shirriff/GBC-audio-chip/headphone-amp.sch

## KiCad design headphone-amp.sch (2020-05-01)

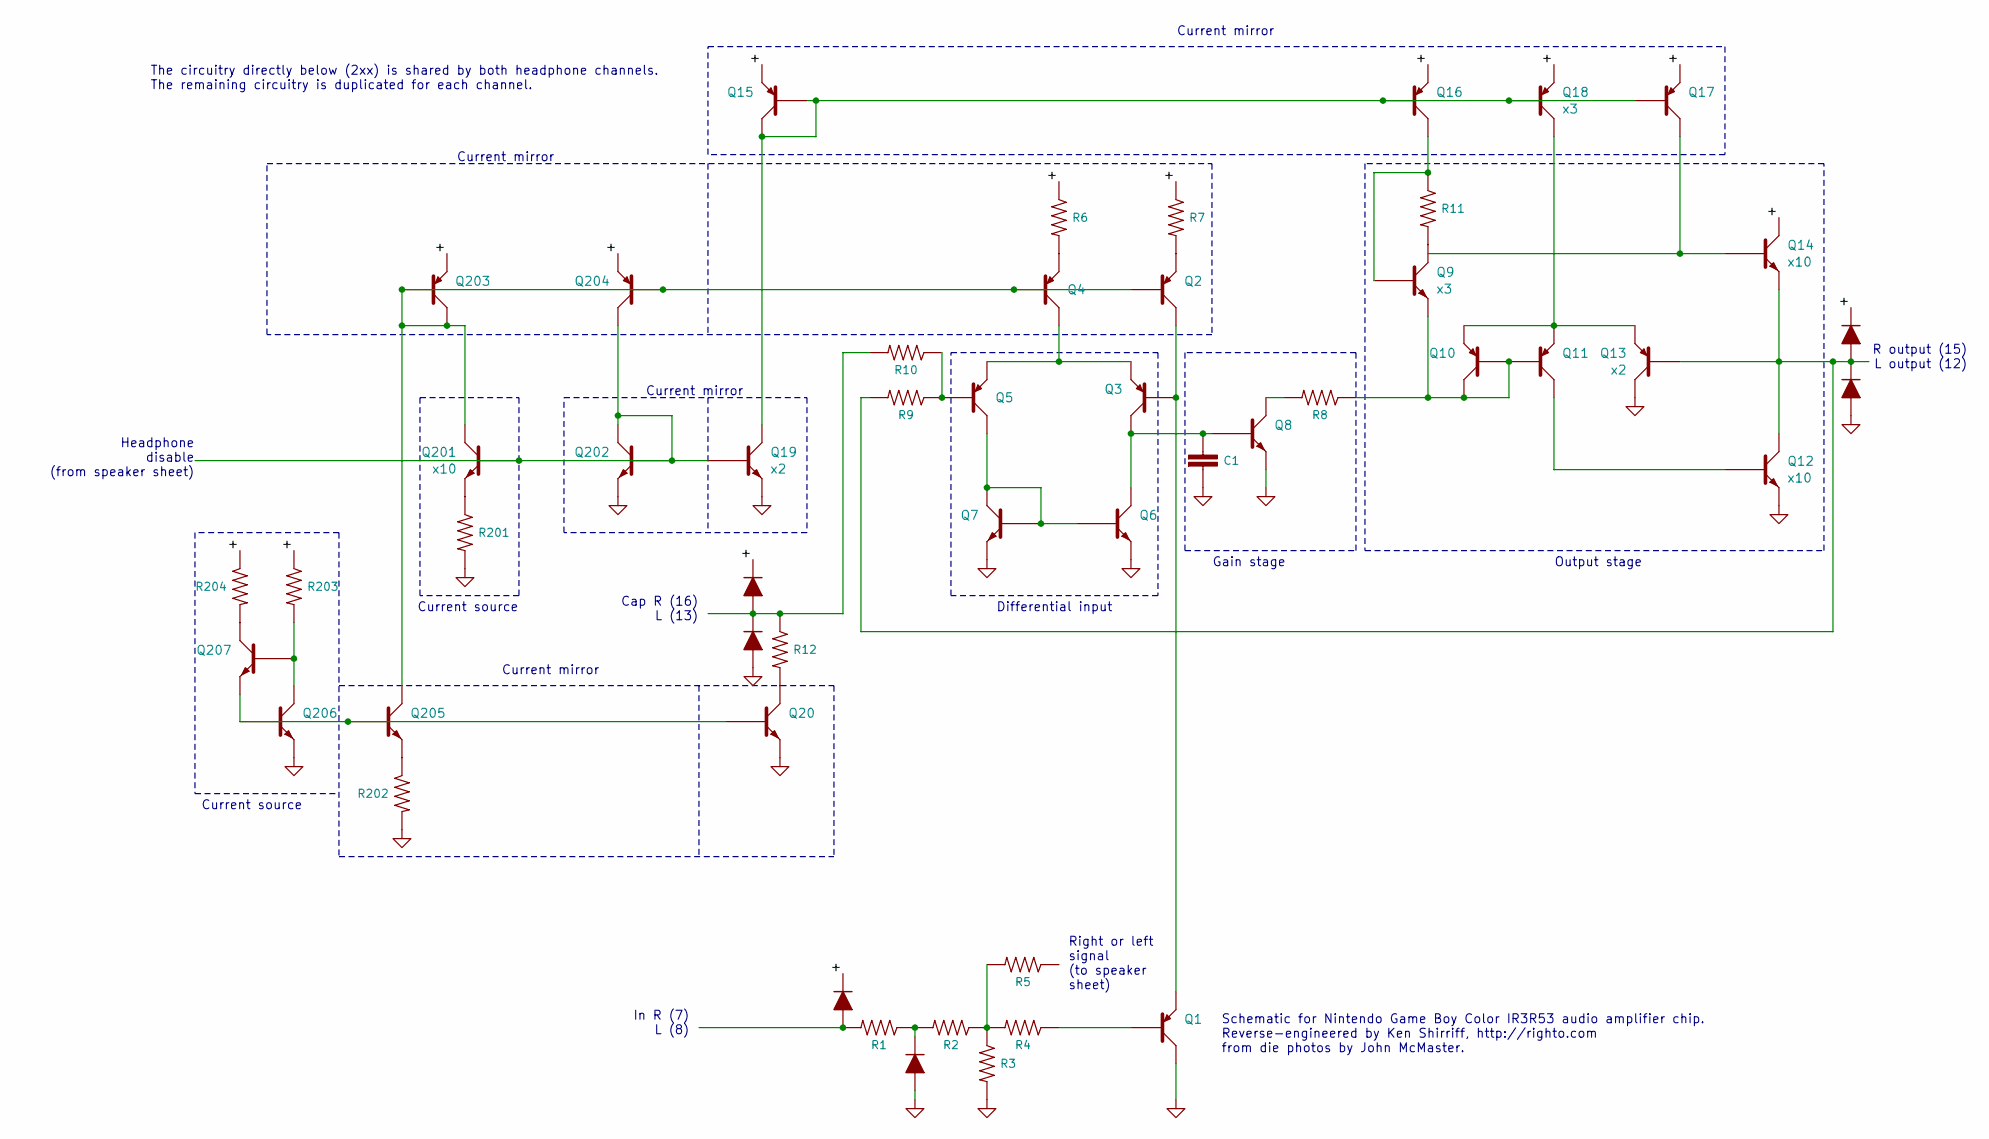
[picture p6: schematic headphone-amp.sch]

Parts:
C1: SPARKFUN-CAPACITORS_0.1UF-0402-16V-10%; SPARKFUN-CAPACITORS_0402
Q1, Q2, Q3, Q4, Q5, Q7, Q15, Q16, Q17, Q202, Q203, Q204, Q205, Q206, Q207: (no value)
Q6, Q8: x6
Q9, Q10, Q11, Q18: x3
Q12, Q14, Q201: x10
Q13, Q19, Q20: x2
R1, R2, R3, R4, R5, R6, R7, R8, R9, R10, R11, R12, R201, R202, R203, R204: SPARKFUN-RESISTORS_0603

Connections:
+: Q14.2 (C), Q15.3 (E), Q16.3 (E), Q17.3 (E), Q18.3 (E), Q203.3 (E), Q204.3 (E), R6.1, R7.1, R203.1, R204.1
GND: C1.2, Q1.2 (C), Q6.3 (E), Q7.3 (E), Q8.3 (E), Q12.3 (E), Q13.2 (C), Q19.3 (E), Q20.3 (E), Q202.3 (E), Q206.3 (E), R3.2, R201.2, R202.2
unnamed: C1.1, Q3.2 (C), Q6.2 (C), Q8.1 (B)
unnamed: Q1.1 (B), R4.1
unnamed: Q1.3 (E), Q2.2 (C), Q3.1 (B)
unnamed: Q2.1 (B), Q4.1 (B), Q201.2 (C), Q203.1 (B), Q203.2 (C), Q204.1 (B), Q205.2 (C)
unnamed: Q2.3 (E), R7.2
unnamed: Q3.3 (E), Q4.2 (C), Q5.3 (E)
unnamed: Q4.3 (E), R6.2
unnamed: Q5.1 (B), R9.1, R10.1
unnamed: Q5.2 (C), Q6.1 (B), Q7.1 (B), Q7.2 (C)
unnamed: Q8.2 (C), R8.2
unnamed: Q9.2 (C), R11.2
unnamed: Q9.3 (E), Q10.1 (B), Q10.2 (C), Q11.1 (B), R8.1
unnamed: Q10.3 (E), Q11.3 (E), Q13.3 (E), Q18.2 (C)
unnamed: Q11.2 (C), Q12.1 (B)
unnamed: Q12.2 (C), Q13.1 (B), Q14.3 (E), R9.2
unnamed: Q14.1 (B), Q17.2 (C)
unnamed: Q15.1 (B), Q15.2 (C), Q16.1 (B), Q17.1 (B), Q18.1 (B), Q19.2 (C)
unnamed: Q9.1 (B), Q16.2 (C), R11.1
unnamed: Q19.1 (B), Q201.1 (B), Q202.1 (B), Q202.2 (C), Q204.2 (C)
unnamed: Q20.1 (B), Q205.1 (B), Q206.1 (B), Q207.3 (E)
unnamed: Q20.2 (C), R12.2
unnamed: Q201.3 (E), R201.1
unnamed: Q205.3 (E), R202.1
unnamed: Q206.2 (C), Q207.1 (B), R203.2
unnamed: Q207.2 (C), R204.2
unnamed: R1.1, R2.2
unnamed: R2.1, R3.1, R4.2, R5.2
unnamed: R10.2, R12.1

Notes on the sheet:
R output (15) L output (12)
Headphone disable (from speaker sheet)
In R (7) L (8)
Right or left signal (to speaker sheet)
Cap R (16) L (13)
Current source
Current mirror
Differential input
Output stage
Gain stage
The circuitry directly below (2xx) is shared by both headphone channels. The remaining circuitry is duplicated for each channel.
Schematic for Nintendo Game Boy Color IR3R53 audio amplifier chip. Reverse-engineered by Ken Shirriff, http://righto.com from die photos by John McMaster.
