shirriff/GBC-audio-chip/speaker-amp.sch

## KiCad design speaker-amp.sch (2020-05-01)

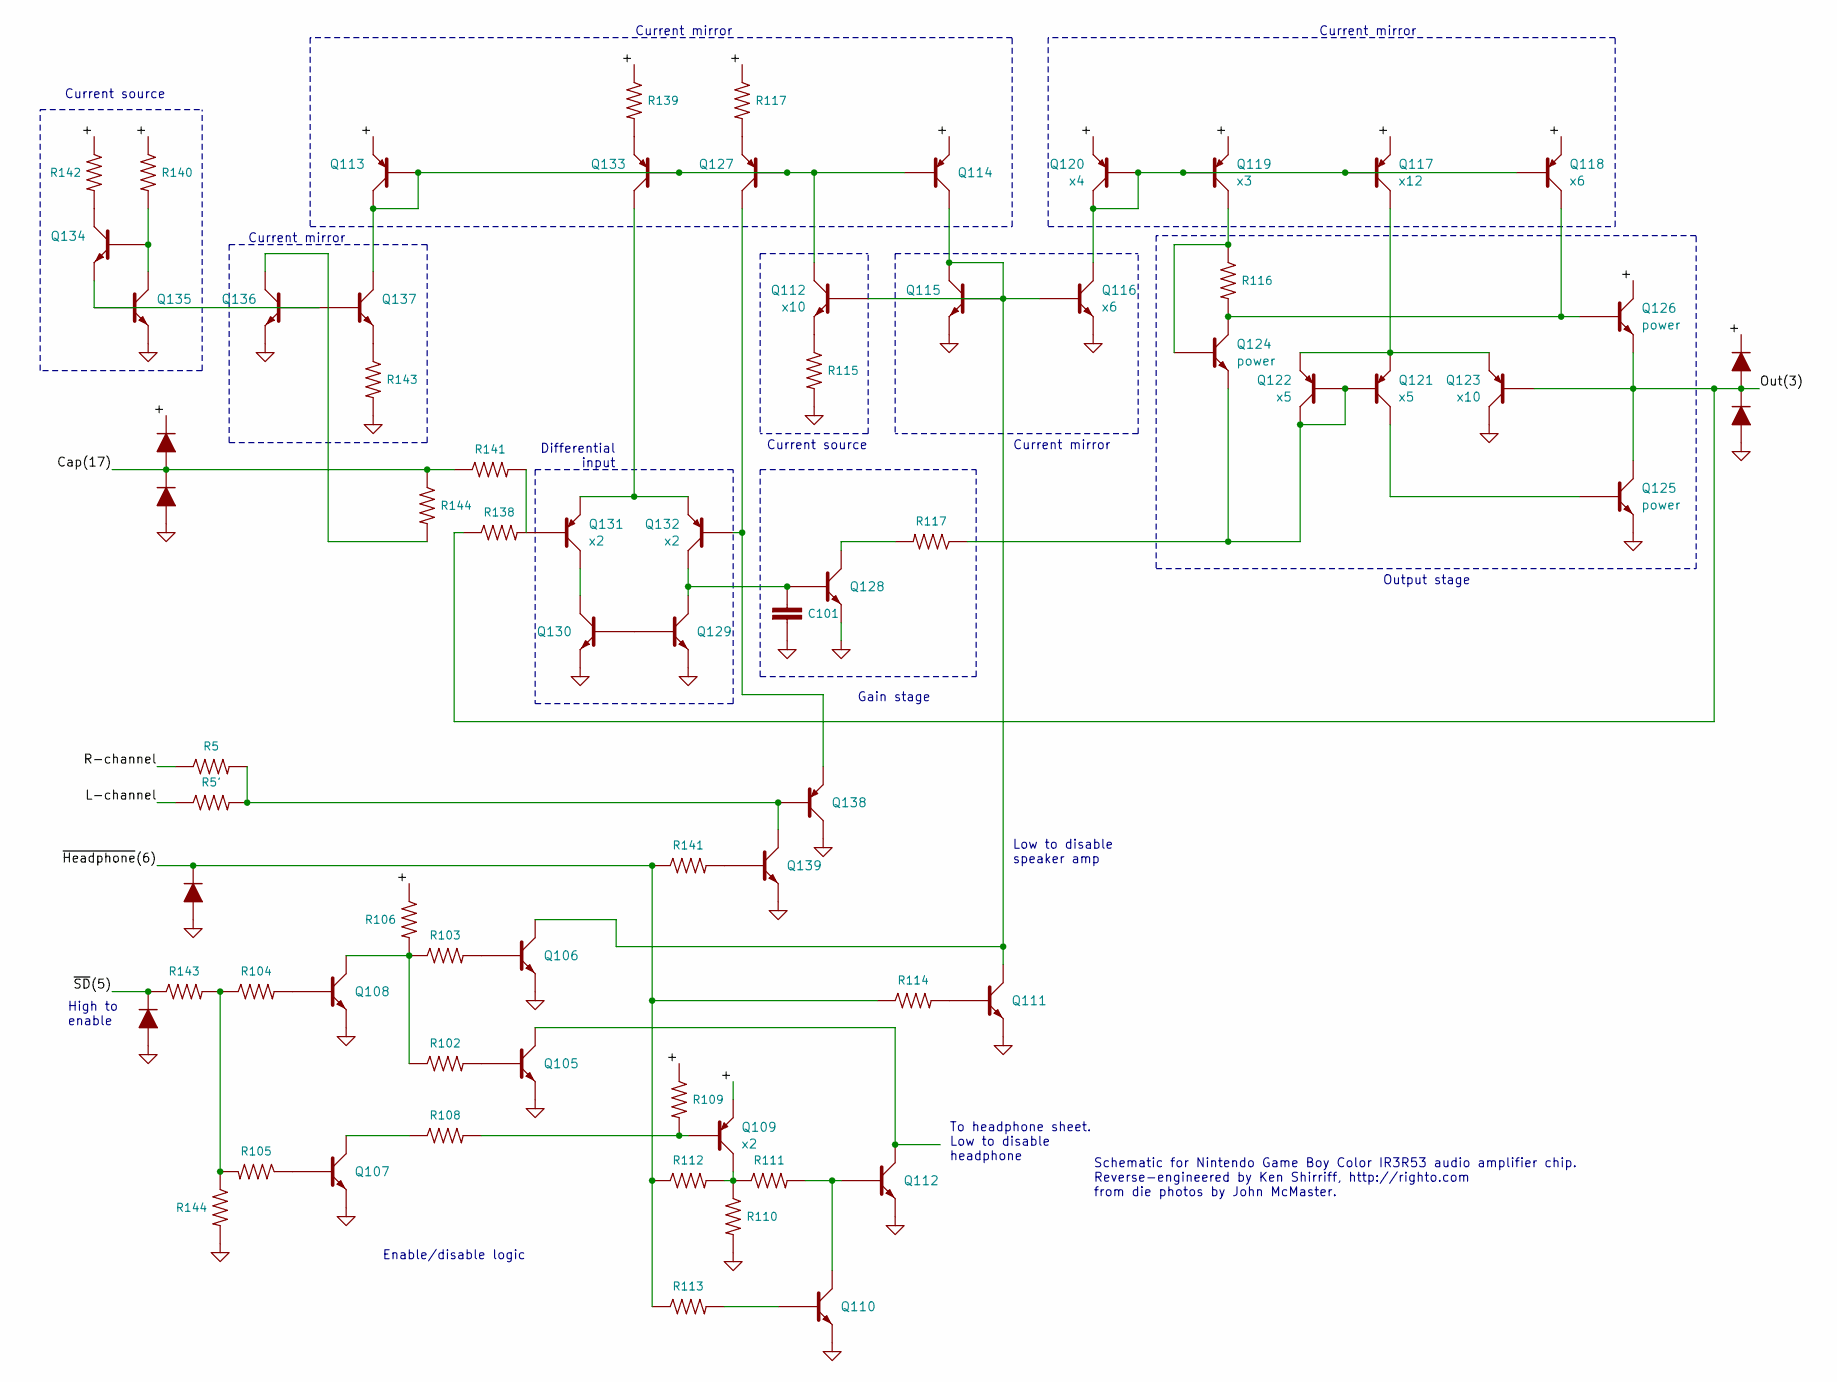
[picture p7: schematic speaker-amp.sch]

Parts:
C101: SPARKFUN-CAPACITORS_0.1UF-0402-16V-10%; SPARKFUN-CAPACITORS_0402
Q105, Q106, Q107, Q108, Q110, Q111, Q113, Q114, Q115, Q127, Q128, Q129, Q130, Q133, Q134, Q135, Q136, Q137, Q138, Q139: (no value)
Q109, Q131, Q132: x2
Q112, Q123: x10
Q116, Q118: x6
Q117: x12
Q119: x3
Q120: x4
Q121, Q122: x5
Q124, Q125, Q126: power
R5, R5', R102, R103, R104, R105, R106, R108, R109, R110, R111, R112, R113, R114, R115, R116, R117, R138, R139, R140, R141, R142, R143, R144: SPARKFUN-RESISTORS_0603

Connections:
+: Q109.3 (E), Q113.3 (E), Q114.3 (E), Q117.3 (E), Q118.3 (E), Q119.3 (E), Q120.3 (E), Q126.2 (C), R106.1, R109.1, R117.1, R139.1, R140.1, R142.1
Cap(17): R141.1, R144.1
GND: C101.2, Q105.3 (E), Q106.3 (E), Q107.3 (E), Q108.3 (E), Q110.3 (E), Q111.3 (E), Q112.3 (E), Q115.3 (E), Q116.3 (E), Q123.2 (C), Q125.3 (E), Q128.3 (E), Q129.3 (E), Q130.3 (E), Q135.3 (E), Q136.3 (E), Q138.2 (C), Q139.3 (E), R110.2, R115.2, R143.2, R144.2
L-channel: R5'.1
unnamed: C101.1, Q128.1 (B), Q129.2 (C), Q132.2 (C)
unnamed: Q105.1 (B), R102.2
unnamed: Q105.2 (C), Q112.2 (C)
unnamed: Q106.1 (B), R103.2
unnamed: Q106.2 (C), Q111.2 (C), Q112.1 (B), Q114.2 (C), Q115.1 (B), Q115.2 (C), Q116.1 (B)
unnamed: Q107.1 (B), R105.1
unnamed: Q107.2 (C), R108.1
unnamed: Q108.1 (B), R104.2
unnamed: Q108.2 (C), R102.1, R103.1, R106.2
unnamed: Q109.1 (B), R108.2, R109.2
unnamed: Q109.2 (C), R110.1, R111.1, R112.2
unnamed: Q110.1 (B), R113.2
unnamed: Q110.2 (C), Q112.1 (B), R111.2
unnamed: Q111.1 (B), R114.2
unnamed: Q112.2 (C), Q113.1 (B), Q113.2 (C), Q114.1 (B), Q127.1 (B), Q133.1 (B), Q137.2 (C)
unnamed: Q112.3 (E), R115.1
unnamed: Q116.2 (C), Q117.1 (B), Q118.1 (B), Q119.1 (B), Q120.1 (B), Q120.2 (C)
unnamed: Q117.2 (C), Q121.3 (E), Q122.3 (E), Q123.3 (E)
unnamed: Q118.2 (C), Q124.2 (C), Q126.1 (B), R116.2
unnamed: Q119.2 (C), Q124.1 (B), R116.1
unnamed: Q121.1 (B), Q122.1 (B), Q122.2 (C), Q124.3 (E), R117.1
unnamed: Q121.2 (C), Q125.1 (B)
unnamed: Q127.2 (C), Q132.1 (B), Q138.3 (E)
unnamed: Q127.3 (E), R117.2
unnamed: Q128.2 (C), R117.2
unnamed: Q129.1 (B), Q130.1 (B)
unnamed: Q130.2 (C), Q131.2 (C)
unnamed: Q131.1 (B), R138.2
unnamed: Q131.3 (E), Q132.3 (E), Q133.2 (C)
unnamed: Q133.3 (E), R139.2
unnamed: Q134.1 (B), Q135.2 (C), R140.2
unnamed: Q134.2 (C), R142.2
unnamed: Q134.3 (E), Q135.1 (B), Q136.1 (B), Q137.1 (B)
unnamed: Q136.2 (C), R144.2
unnamed: Q137.3 (E), R143.1
unnamed: Q138.1 (B), Q139.2 (C), R5.2, R5'.2
unnamed: Q139.1 (B), R141.2
unnamed: R104.1, R105.2, R143.2, R144.1
Out(3): Q123.1 (B), Q125.2 (C), Q126.3 (E), R138.1
R-channel: R5.1
~Headphone~(6): R112.1, R113.1, R114.1, R141.1
~SD~(5): R143.1

Notes on the sheet:
To headphone sheet. Low to disable headphone
Low to disable speaker amp
High to enable
Current source
Current mirror
Differential input
Output stage
Gain stage
Enable/disable logic
Schematic for Nintendo Game Boy Color IR3R53 audio amplifier chip. Reverse-engineered by Ken Shirriff, http://righto.com from die photos by John McMaster.
