shirriff/GBC-audio-chip/(commit log)

2020-05-01 Initial commit.
    [IR3R53.sch, headphone-amp.sch, speaker-amp.sch]
2020-05-02 Add circuit details to the README.
2020-05-30 Schematic of the Game Boy audio amplifier chip.
